purduerov/X19-Power-Slab-Board/X19-Power-Slab-Board.csv

Reference | Qty | Value | DNP | Exclude from BOM | Exclude from Board | Footprint | Datasheet | Manufacturer_Name | Manufacturer_Part_Number
3.3V1 | 1 | 3.3V |  |  |  | TestPoint:TestPoint_Pad_D2.5mm
5.1V1 | 1 | 5.1V |  |  |  | TestPoint:TestPoint_Pad_D2.5mm
12V1 | 1 | 12V |  |  |  | TestPoint:TestPoint_Pad_D4.0mm
48V1 | 1 | 48V |  |  |  | TestPoint:TestPoint_Pad_D4.0mm
B2,B3,B4,B5 | 4 | E48SC12030NRFH |  |  |  | rov_power:E48SC12030NRFH | https://filecenter.deltaww.com/products/download/01/0102/datasheet/DS_E48SC12030.pdf | Delta Electronics | E48SC12030NRFH
C1,C2 | 2 | 470u |  |  |  | Capacitor_THT:CP_Radial_D13.0mm_P5.00mm
C3 | 1 | 10u |  |  |  | Capacitor_SMD:C_1206_3216Metric_Pad1.33x1.80mm_HandSolder
C4,C5,C6,C19,C42,C43 | 6 | 0.1uF |  |  |  | Capacitor_SMD:C_0603_1608Metric_Pad1.08x0.95mm_HandSolder
C7,C9,C10,C12 | 4 | 100n |  |  |  | Capacitor_SMD:C_0603_1608Metric_Pad1.08x0.95mm_HandSolder
C8,C14 | 2 | 27pF |  |  |  | Capacitor_SMD:C_0603_1608Metric_Pad1.08x0.95mm_HandSolder
C11 | 1 | 4.7u |  |  |  | Capacitor_SMD:C_1206_3216Metric_Pad1.33x1.80mm_HandSolder
C13 | 1 | 2.2u |  |  |  | Capacitor_SMD:C_1206_3216Metric_Pad1.33x1.80mm_HandSolder
C15 | 1 | 0.1u |  |  |  | Capacitor_SMD:C_0603_1608Metric_Pad1.08x0.95mm_HandSolder
C16,C22,C30,C34,C39 | 5 | 100uF |  |  |  | Capacitor_THT:CP_Radial_D10.0mm_P5.00mm
C17,C18,C21 | 3 | 1uF |  |  |  | Capacitor_SMD:C_0603_1608Metric_Pad1.08x0.95mm_HandSolder
C20 | 1 | 22uF |  |  |  | Capacitor_SMD:C_1206_3216Metric_Pad1.33x1.80mm_HandSolder
C23,C26,C27,C31,C32,C33,C37,C38 | 8 | 1uF |  |  |  | Capacitor_SMD:C_0805_2012Metric_Pad1.18x1.45mm_HandSolder
C24,C25,C28,C29,C35,C36,C40,C41 | 8 | 470uF |  |  |  | Capacitor_THT:CP_Radial_D10.0mm_P5.00mm
C44 | 1 | 4.7n | DNP |  |  | Capacitor_SMD:C_0603_1608Metric_Pad1.08x0.95mm_HandSolder
CR2 | 1 | ESD2CAN24DBZRQ1 |  |  |  | Package_TO_SOT_SMD:SOT-23_Handsoldering | ESD2CAN24DBZRQ1
D1 | 1 | LED |  |  |  | LED_SMD:LED_0805_2012Metric_Pad1.15x1.40mm_HandSolder
D2 | 1 | SMCJ58A |  |  |  | Diode_SMD:D_SMC | https://www.littelfuse.com/assetdocs/littelfuse_tvs_diode_smcj_datasheet.pdf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
D3,D6 | 2 | YELLOW |  |  |  | LED_SMD:LED_0805_2012Metric_Pad1.15x1.40mm_HandSolder
D5 | 1 | GREEN |  |  |  | LED_SMD:LED_0805_2012Metric_Pad1.15x1.40mm_HandSolder
GND1 | 1 | GND |  |  |  | TestPoint:TestPoint_Pad_D2.5mm
J1,J3 | 2 | Conn_01x03_Pin |  |  |  | Connector_PinHeader_2.54mm:PinHeader_1x03_P2.54mm_Vertical
J2 | 1 | 796636-6 |  |  |  | rov_connectors:CON6_P5MM_VER_TERM-BLK_TYC | https://www.te.com/commerce/DocumentDelivery/DDEController?Action=srchrtrv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
J4 | 1 | Conn_01x04_Pin |  |  |  | Connector_PinHeader_2.54mm:PinHeader_1x04_P2.54mm_Vertical
J5 | 1 | Conn_02x05_Odd_Even |  |  |  | Connector_PinHeader_2.54mm:PinHeader_2x05_P2.54mm_Vertical
J6,J7,J8,J9,J10,J11,J12,J13 | 8 | Conn_01x02 |  |  |  | Connector_PinHeader_2.54mm:PinHeader_1x02_P2.54mm_Vertical
J14 | 1 | Conn_01x05 |  |  |  | Connector_PinHeader_2.54mm:PinHeader_1x05_P2.54mm_Vertical
PG1,PG2,PG3,PG4 | 4 | TestPoint |  |  |  | TestPoint:TestPoint_Pad_D2.5mm
R1 | 1 | 300 |  |  |  | Resistor_SMD:R_0603_1608Metric_Pad0.98x0.95mm_HandSolder
R2 | 1 | 1000 |  |  |  | Resistor_SMD:R_0603_1608Metric_Pad0.98x0.95mm_HandSolder
R3,R7 | 2 | 120 |  |  |  | Resistor_SMD:R_0603_1608Metric_Pad0.98x0.95mm_HandSolder
R6,R8,R9,R10 | 4 | 4.7k |  |  |  | Resistor_SMD:R_0603_1608Metric_Pad0.98x0.95mm_HandSolder
R11 | 1 | 10k |  |  |  | Resistor_THT:R_Array_SIP4
R13 | 1 | 10K |  |  |  | Resistor_SMD:R_0603_1608Metric_Pad0.98x0.95mm_HandSolder
R14 | 1 | 15.4K |  |  |  | Resistor_SMD:R_0603_1608Metric_Pad0.98x0.95mm_HandSolder
R15 | 1 | 23.7K |  |  |  | Resistor_SMD:R_0603_1608Metric_Pad0.98x0.95mm_HandSolder
R16 | 1 | 36.5K |  |  |  | Resistor_SMD:R_0603_1608Metric_Pad0.98x0.95mm_HandSolder
R17,R18,R19,R20 | 4 | 54.9K |  |  |  | Resistor_SMD:R_0603_1608Metric_Pad0.98x0.95mm_HandSolder
R21,R22 | 2 | 4.7K |  |  |  | Resistor_SMD:R_0603_1608Metric_Pad0.98x0.95mm_HandSolder
R23,R24 | 2 | SR: 1m |  |  |  | Resistor_SMD:R_2512_6332Metric_Pad1.40x3.35mm_HandSolder
R25,R26 | 2 | 60 | DNP |  |  | Resistor_SMD:R_0603_1608Metric_Pad0.98x0.95mm_HandSolder
R27 | 1 | 798K |  |  |  | Resistor_SMD:R_0603_1608Metric_Pad0.98x0.95mm_HandSolder
R28 | 1 | 10k |  |  |  | Resistor_SMD:R_0603_1608Metric_Pad0.98x0.95mm_HandSolder
SW1 | 1 | SW_Push |  |  |  | Button_Switch_THT:SW_NKK_GW12LJP
TP6,TP7 | 2 | TestPoint |  |  |  | TestPoint:TestPoint_Pad_D4.0mm
U1 | 1 | TCAN1044AEV-Q1 |  |  |  | rov_logic:D0008A-IPC_A | https://www.ti.com/lit/ds/symlink/tcan1044aev-q1.pdf?ts=1718715491235
U2 | 1 | TMP1075NDRLR |  |  |  | rov_sensors:SOT5X3-6_DRL_TEX | https://www.ti.com/lit/gpn/tmp1075
U3 | 1 | STM32C542CCT6 |  |  |  | rov_logic:LQFP48-7X7 | https://www.st.com/resource/en/datasheet/stm32c542cc.pdf
U4 | 1 | MIC5504-3.3YM5-TR |  |  |  | rov_power:SOT-23-5_MC_MCH | MIC5504-3.3YM5-TR
U5,U6 | 2 | INA237AIDGSR |  |  |  | rov_sensors:VSSOP_IDGSR_TEX | https://www.ti.com/lit/gpn/ina237
U7 | 1 | i6A4W020A033V-003-R |  |  |  | i6A4W_DIP_FULL_TDK.kicad_mod:i6A4W_DIP_FULL_TDK | https://product.tdk.com/system/files/dam/doc/product/power/switching-power/dc-dc-converter/catalog/i6a4w_e.pdf
Y1 | 1 | ABM8G-16.000MHZ-18-D2Y-T |  |  |  | footprints:CRYSTAL_ABM8G_ABR | ABM8G-16.000MHZ-18-D2Y-T
