purduerov/X19-Power-Slab-Board/DigikeyParts/E48SC12030NRFH/E48SC12030NRFH/3D/E48SC12030NRFH.stp

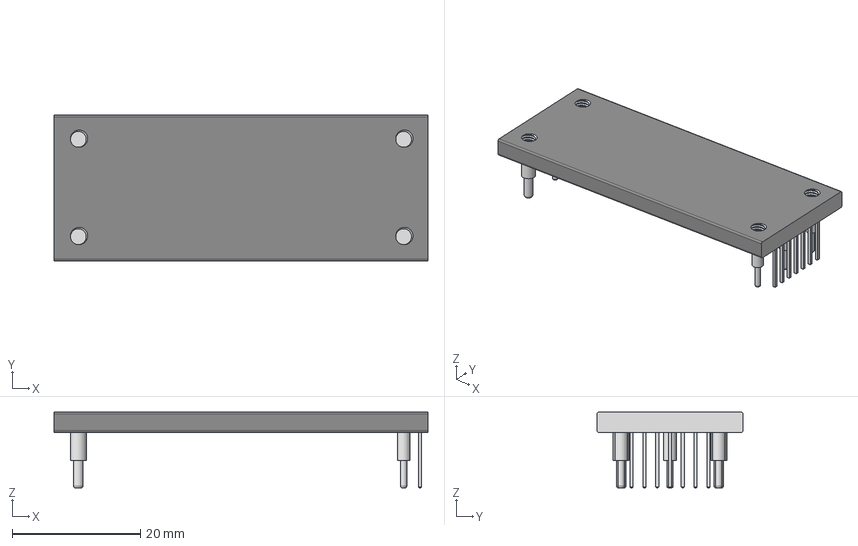
[picture p1: CAD file, 2026-09-21]
DigikeyParts/E48SC12030NRFH/E48SC12030NRFH/3D/E48SC12030NRFH.stp
58.4 x 22.8 x 11.9 mm
