purduerov/X19-Power-Slab-Board/DigikeyParts/LIB_IRS-5_10-Q12P-C/IRS-5_10-Q12P-C/3D/IRS-5_10-Q12P-C.stp

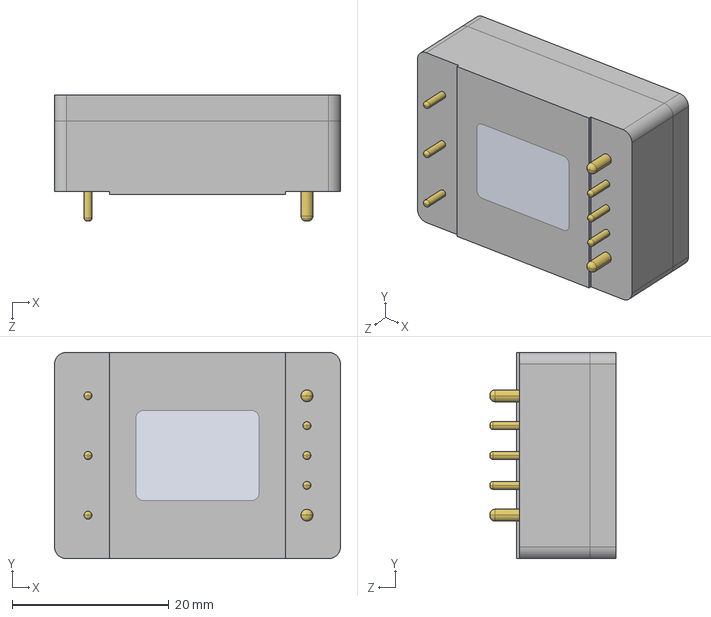
[picture p2: CAD file, 2026-10-07]
DigikeyParts/LIB_IRS-5_10-Q12P-C/IRS-5_10-Q12P-C/3D/IRS-5_10-Q12P-C.stp
36.5 x 26.3 x 16.1 mm
