purduerov/X19-Power-Slab-Board/DigikeyParts/XT60_YELLOW/XT60_YELLOW.step

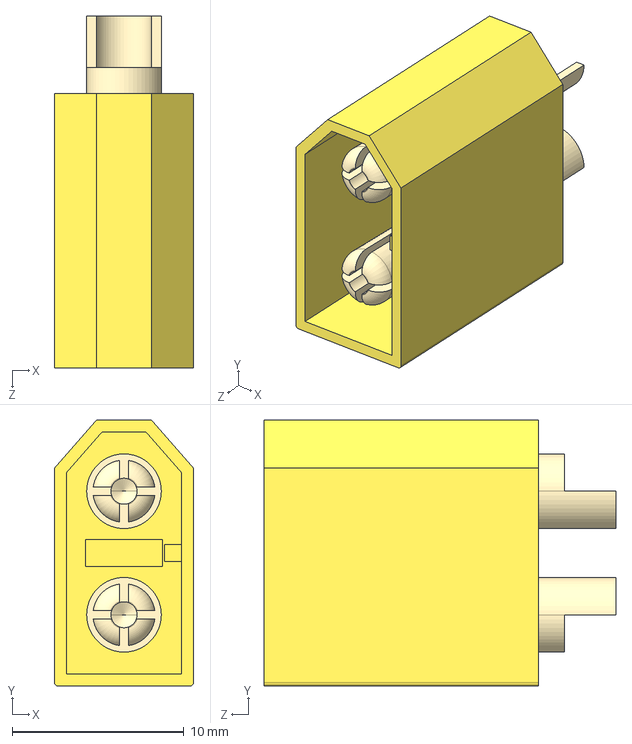
[picture p3: CAD file, 2026-10-28]
DigikeyParts/XT60_YELLOW/XT60_YELLOW.step
8.10 x 15.5 x 20.5 mm
