purduerov/X19-Power-Slab-Board/(list of files, cad)

Other CAD files:
DigikeyParts/E48SC12030NRFH/E48SC12030NRFH/Allegro/e48sc12030nrfh.psm
DigikeyParts/E48SC12030NRFH/E48SC12030NRFH/DEHDL/e48sc12030nrfh/chips/chips.prt
DigikeyParts/LIB_IRS-5_10-Q12P-C/IRS-5_10-Q12P-C/DEHDL/irs_5_10_q12p_c/chips/chips.prt
