purduerov/X19-Power-Slab-Board/(list of files, drawings)

Other design files:
DigikeyParts/E48SC12030NRFH/E48SC12030NRFH/Altium/E48SC12030NRFH.PcbLib
DigikeyParts/E48SC12030NRFH/E48SC12030NRFH/Altium/E48SC12030NRFH.SchLib
