purduerov/X19-Power-Slab-Board/X19-Power-Slab-Board.kicad_pcb

## KiCad design X19-Power-Slab-Board.kicad_pcb (2026-11-14)

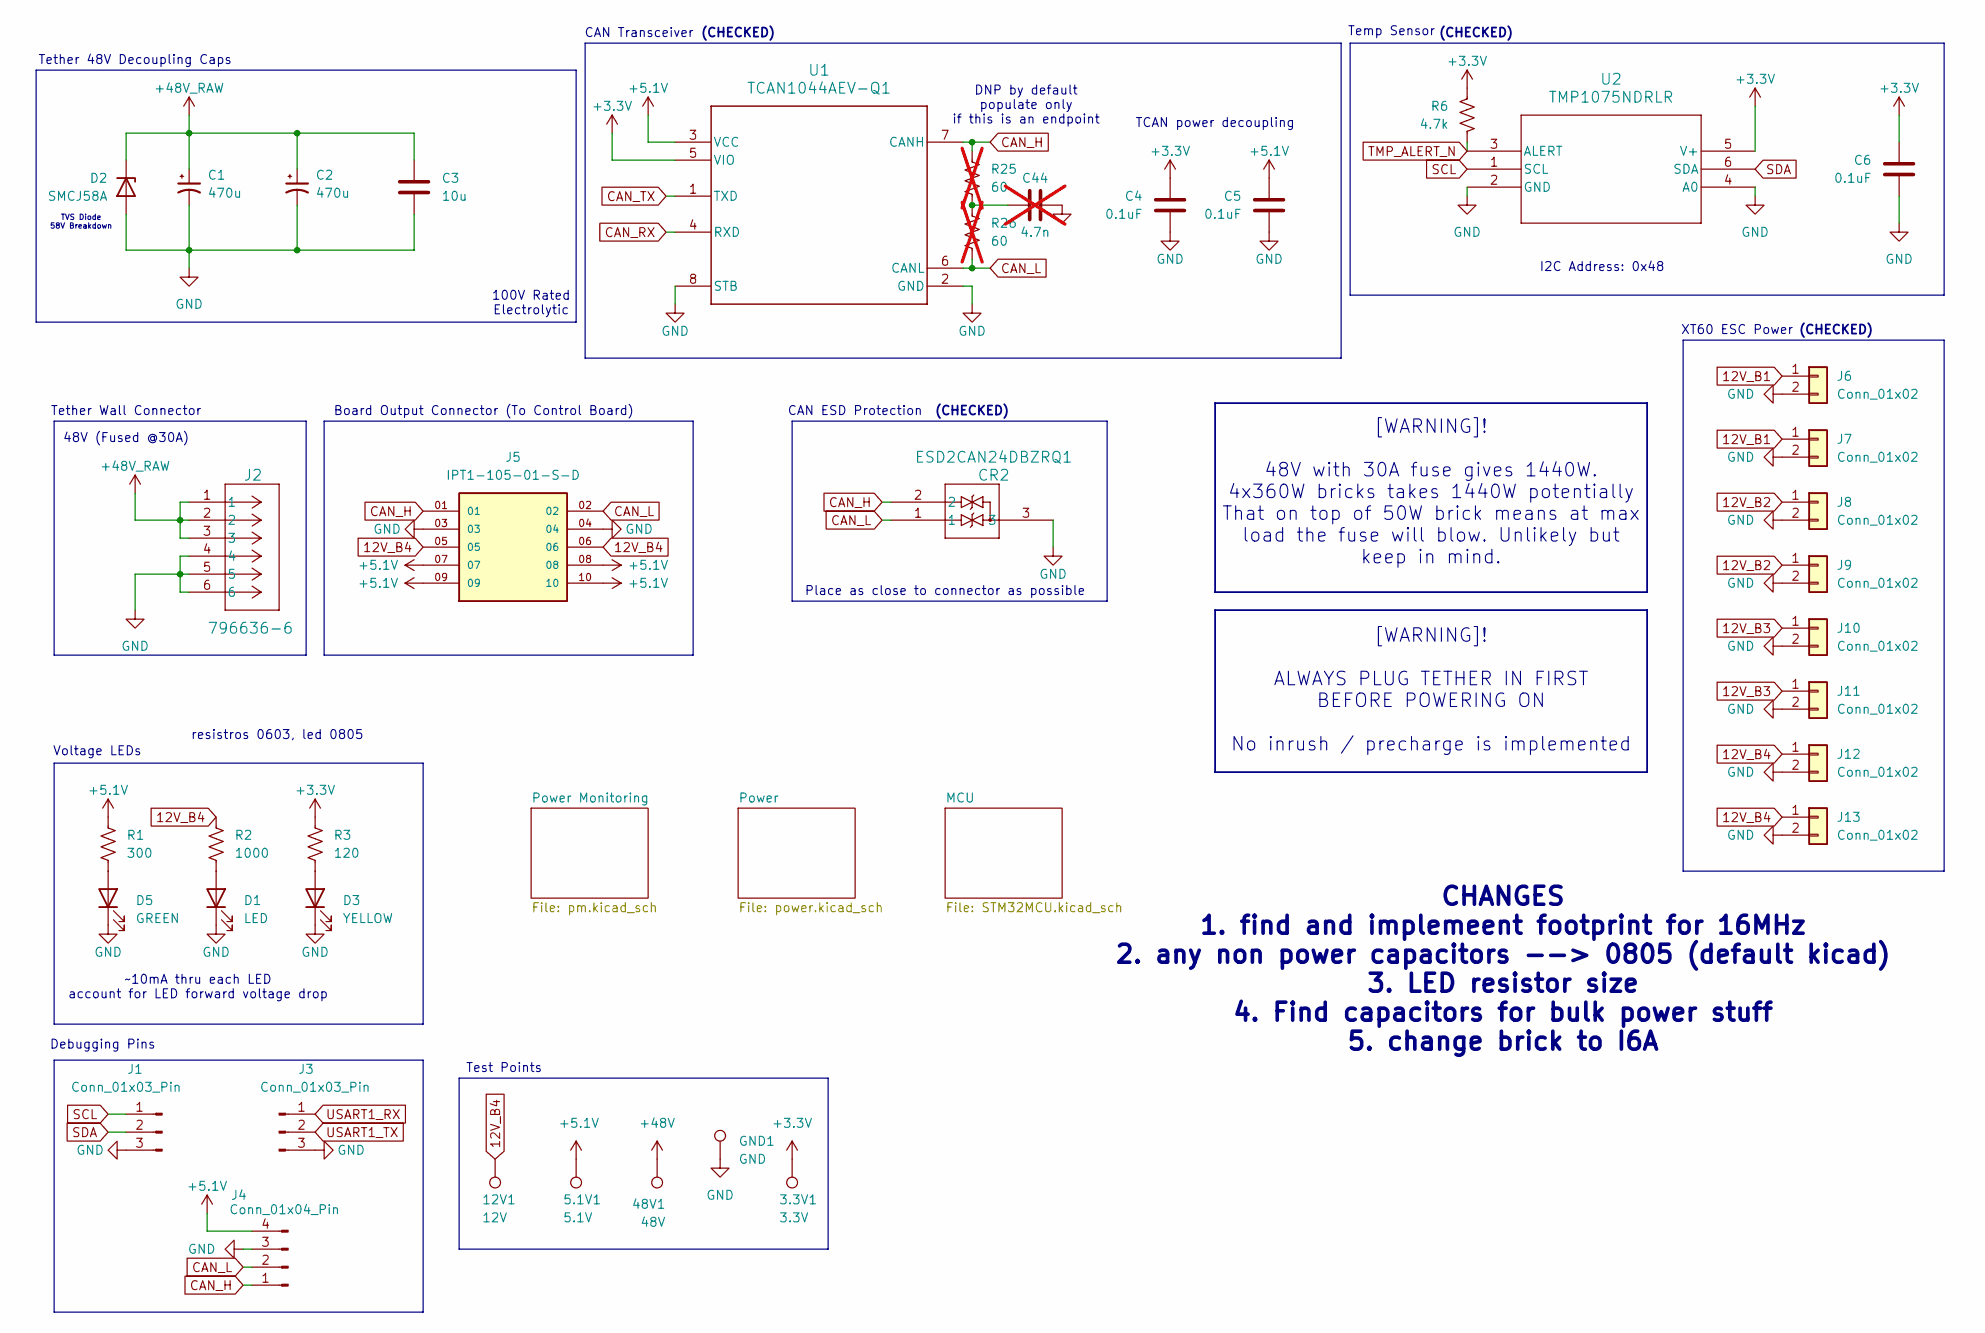
[picture p4: schematic X19-Power-Slab-Board.kicad_sch, Purdue ROV Subsystem Board]

Parts:
3.3V1: 3.3V; TestPoint_Pad_D2.5mm
5.1V1: 5.1V; TestPoint_Pad_D2.5mm
12V1: 12V; TestPoint_Pad_D4.0mm
48V1: 48V; TestPoint_Pad_D4.0mm
C1, C2: 470u; CP_Radial_D13.0mm_P5.00mm
C3: 10u; C_1206_3216Metric_Pad1.33x1.80mm_HandSolder
C4, C5, C6: 0.1uF; C_0603_1608Metric_Pad1.08x0.95mm_HandSolder
C44: 4.7n; C_0603_1608Metric_Pad1.08x0.95mm_HandSolder; not fitted
CR2: ESD2CAN24DBZRQ1; SOT-23_Handsoldering
D1: LED; LED_0805_2012Metric_Pad1.15x1.40mm_HandSolder
D2: SMCJ58A; D_SMC
D3: YELLOW; LED_0805_2012Metric_Pad1.15x1.40mm_HandSolder
D5: GREEN; LED_0805_2012Metric_Pad1.15x1.40mm_HandSolder
GND1: GND; TestPoint_Pad_D2.5mm
J1, J3: Conn_01x03_Pin; PinHeader_1x03_P2.54mm_Vertical
J2: 796636-6; CON6_P5MM_VER_TERM-BLK_TYC
J4: Conn_01x04_Pin; PinHeader_1x04_P2.54mm_Vertical
J5: IPT1-105-01-S-D; SAMTEC_IPT1-105-01-S-D; PARTREV R
J6, J7, J8, J9, J10, J11, J12, J13: Conn_01x02; AMASS_XT60PB-M
R1: 300; R_0603_1608Metric_Pad0.98x0.95mm_HandSolder
R2: 1000; R_0603_1608Metric_Pad0.98x0.95mm_HandSolder
R3: 120; R_0603_1608Metric_Pad0.98x0.95mm_HandSolder
R6: 4.7k; R_0603_1608Metric_Pad0.98x0.95mm_HandSolder
R25, R26: 60; R_0603_1608Metric_Pad0.98x0.95mm_HandSolder; not fitted
U1: TCAN1044AEV-Q1; D0008A-IPC_A
U2: TMP1075NDRLR; SOT5X3-6_DRL_TEX

Connections:
12V_B1: J6.1, J7.1; also elsewhere on the board
12V_B2: J8.1, J9.1; also elsewhere on the board
12V_B3: J10.1, J11.1; also elsewhere on the board
12V_B4: 12V1.1 (1_1), J5.05, J5.06, J12.1, J13.1, R2.2; also elsewhere on the board
+3.3V: 3.3V1.1 (1_1), C4.1, C6.1, R3.2, R6.1, U1.5 (VIO), U2.5 (V+); also elsewhere on the board
+5.1V: 5.1V1.1 (1_1), C5.1, J4.4, J5.07, J5.08, J5.09, J5.10, R1.2, U1.3 (VCC); also elsewhere on the board
+48V: 48V1.1 (1_1); also elsewhere on the board
+48V_RAW: C1.1, C2.1, C3.1, D2.1 (K), J2.1, J2.2, J2.3; also elsewhere on the board
CAN_H: CR2.2, J4.1, J5.01, R25.1, U1.7 (CANH)
CAN_L: CR2.1, J4.2, J5.02, R26.2, U1.6 (CANL)
CAN_RX: U1.4 (RXD); also elsewhere on the board
CAN_TX: U1.1 (TXD); also elsewhere on the board
GND: C1.2, C2.2, C3.2, C4.2, C5.2, C6.2, C44.2, CR2.3, D1.1 (K), D2.2 (A), D3.1 (K), D5.1 (K), GND1.1 (1_1), J1.3, J2.4, J2.5, J2.6, J3.3, J4.3, J5.03, J5.04, J6.2, J7.2, J8.2, J9.2, J10.2, J11.2, J12.2, J13.2, U1.2 (GND), U1.8 (STB), U2.2 (GND), U2.4 (A0); also elsewhere on the board
unnamed: C44.1, R25.2, R26.1
unnamed: D1.2 (A), R2.1
unnamed: D3.2 (A), R3.1
unnamed: D5.2 (A), R1.1
SCL: J1.1, U2.1 (SCL); also elsewhere on the board
SDA: J1.2, U2.6 (SDA); also elsewhere on the board
TMP_ALERT_N: R6.2, U2.3 (ALERT); also elsewhere on the board
USART1_RX: J3.1; also elsewhere on the board
USART1_TX: J3.2; also elsewhere on the board

Notes on the sheet:
TCAN power decoupling
(CHECKED)
resistros 0603, led 0805
100V Rated Electrolytic
XT60 ESC Power
CAN Transceiver
I2C Address: 0x48
DNP by default populate only if this is an endpoint
[WARNING]! 48V with 30A fuse gives 1440W. 4x360W bricks takes 1440W potentially That on top of 50W brick means at max load the fuse will blow. Unlikely but keep in mind.
Place as close to connector as possible
Temp Sensor
Board Output Connector (To Control Board)
TVS Diode 58V Breakdown
~10mA thru each LED account for LED forward voltage drop
CAN ESD Protection
Tether 48V Decoupling Caps
Voltage LEDs
CHANGES 1. find and implemeent footprint for 16MHz 2. any non power capacitors --> 0805 (default kicad) 3. LED resistor size 4. Find capacitors for bulk power stuff 5. change brick to I6A
[WARNING]! ALWAYS PLUG TETHER IN FIRST BEFORE POWERING ON No inrush / precharge is implemented
Test Points
Debugging Pins
Tether Wall Connector
48V (Fused @30A)

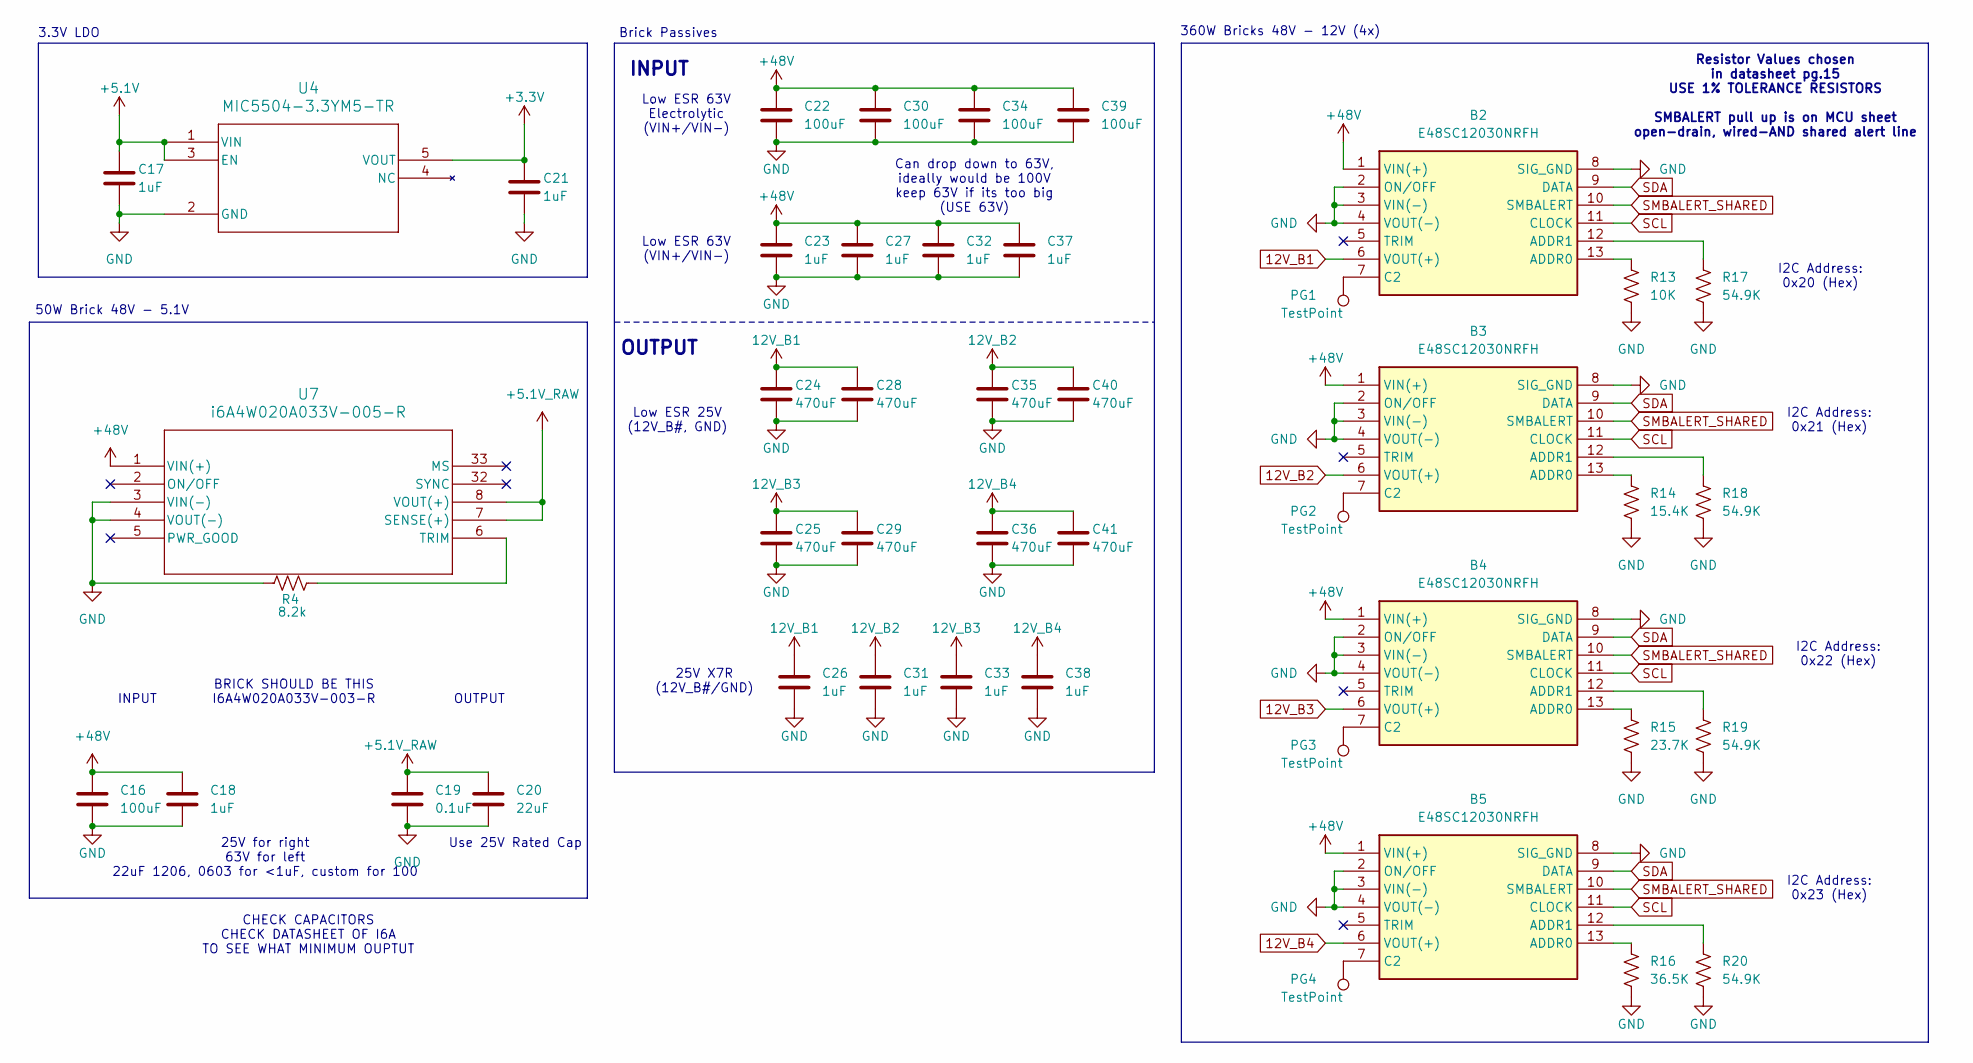
[picture p5: schematic power.kicad_sch]

Parts:
B2, B3, B4, B5: E48SC12030NRFH; Manufacturer_Part_Number E48SC12030NRFH
C16, C22, C30, C34, C39: 100uF; CP_Radial_D10.0mm_P5.00mm
C17, C18, C21: 1uF; C_0603_1608Metric_Pad1.08x0.95mm_HandSolder
C19: 0.1uF; C_0603_1608Metric_Pad1.08x0.95mm_HandSolder
C20: 22uF; C_1206_3216Metric_Pad1.33x1.80mm_HandSolder
C23, C26, C27, C31, C32, C33, C37, C38: 1uF; C_0805_2012Metric_Pad1.18x1.45mm_HandSolder
C24, C25, C28, C29, C35, C36, C40, C41: 470uF; CP_Radial_D10.0mm_P5.00mm
PG1, PG2, PG3, PG4: TestPoint; TestPoint_Pad_D2.5mm
R4: 8.2k; R_0603_1608Metric_Pad0.98x0.95mm_HandSolder
R13: 10K; R_0603_1608Metric_Pad0.98x0.95mm_HandSolder
R14: 15.4K; R_0603_1608Metric_Pad0.98x0.95mm_HandSolder
R15: 23.7K; R_0603_1608Metric_Pad0.98x0.95mm_HandSolder
R16: 36.5K; R_0603_1608Metric_Pad0.98x0.95mm_HandSolder
R17, R18, R19, R20: 54.9K; R_0603_1608Metric_Pad0.98x0.95mm_HandSolder
U4: MIC5504-3.3YM5-TR; SOT-23-5_MC_MCH
U7: i6A4W020A033V-005-R; i6A4W_DIP_FULL_TDK

Connections:
12V_B1: B2.6 (VOUT(+)), C24.1, C26.1, C28.1; also elsewhere on the board
12V_B2: B3.6 (VOUT(+)), C31.1, C35.1, C40.1; also elsewhere on the board
12V_B3: B4.6 (VOUT(+)), C25.1, C29.1, C33.1; also elsewhere on the board
12V_B4: B5.6 (VOUT(+)), C36.1, C38.1, C41.1; also elsewhere on the board
+3.3V: C21.1, U4.5 (VOUT); also elsewhere on the board
+5.1V: C17.1, U4.1 (VIN), U4.3 (EN); also elsewhere on the board
+5.1V_RAW: C19.1, C20.1, U7.7 (SENSE(+)), U7.8 (VOUT(+)); also elsewhere on the board
+48V: B2.1 (VIN(+)), B3.1 (VIN(+)), B4.1 (VIN(+)), B5.1 (VIN(+)), C16.1, C18.1, C22.1, C23.1, C27.1, C30.1, C32.1, C34.1, C37.1, C39.1, U7.1 (VIN(+)); also elsewhere on the board
GND: B2.2 (ON/OFF), B2.3 (VIN(-)), B2.4 (VOUT(-)), B2.8 (SIG_GND), B3.2 (ON/OFF), B3.3 (VIN(-)), B3.4 (VOUT(-)), B3.8 (SIG_GND), B4.2 (ON/OFF), B4.3 (VIN(-)), B4.4 (VOUT(-)), B4.8 (SIG_GND), B5.2 (ON/OFF), B5.3 (VIN(-)), B5.4 (VOUT(-)), B5.8 (SIG_GND), C16.2, C17.2, C18.2, C19.2, C20.2, C21.2, C22.2, C23.2, C24.2, C25.2, C26.2, C27.2, C28.2, C29.2, C30.2, C31.2, C32.2, C33.2, C34.2, C35.2, C36.2, C37.2, C38.2, C39.2, C40.2, C41.2, R4.1, R13.2, R14.2, R15.2, R16.2, R17.2, R18.2, R19.2, R20.2, U4.2 (GND), U7.3 (VIN(-)), U7.4 (VOUT(-)); also elsewhere on the board
unnamed: B2.13 (ADDR0), R13.1
unnamed: B2.12 (ADDR1), R17.1
unnamed: B2.7 (C2), PG1.1 (1_1)
unnamed: B3.13 (ADDR0), R14.1
unnamed: B3.12 (ADDR1), R18.1
unnamed: B3.7 (C2), PG2.1 (1_1)
unnamed: B4.13 (ADDR0), R15.1
unnamed: B4.12 (ADDR1), R19.1
unnamed: B4.7 (C2), PG3.1 (1_1)
unnamed: B5.13 (ADDR0), R16.1
unnamed: B5.12 (ADDR1), R20.1
unnamed: B5.7 (C2), PG4.1 (1_1)
unnamed: R4.2, U7.6 (TRIM)
SCL: B2.11 (CLOCK), B3.11 (CLOCK), B4.11 (CLOCK), B5.11 (CLOCK); also elsewhere on the board
SDA: B2.9 (DATA), B3.9 (DATA), B4.9 (DATA), B5.9 (DATA); also elsewhere on the board
SMBALERT_SHARED: B2.10 (SMBALERT), B3.10 (SMBALERT), B4.10 (SMBALERT), B5.10 (SMBALERT); also elsewhere on the board

Notes on the sheet:
3.3V LDO
CHECK CAPACITORS CHECK DATASHEET OF I6A TO SEE WHAT MINIMUM OUPTUT
360W Bricks 48V - 12V (4x)
Brick Passives
Low ESR 63V (VIN+/VIN-)
50W Brick 48V - 5.1V
Use 25V Rated Cap
OUTPUT
INPUT
I2C Address: 0x21 (Hex)
Low ESR 63V Electrolytic (VIN+/VIN-)
I2C Address: 0x20 (Hex)
Low ESR 25V (12V_B#, GND)
25V for right 63V for left 22uF 1206, 0603 for <1uF, custom for 100
BRICK SHOULD BE THIS I6A4W020A033V-003-R
Resistor Values chosen in datasheet pg.15 USE 1% TOLERANCE RESISTORS SMBALERT pull up is on MCU sheet open-drain, wired-AND shared alert line
25V X7R (12V_B#/GND)
I2C Address: 0x22 (Hex)
Can drop down to 63V, ideally would be 100V keep 63V if its too big (USE 63V)
I2C Address: 0x23 (Hex)

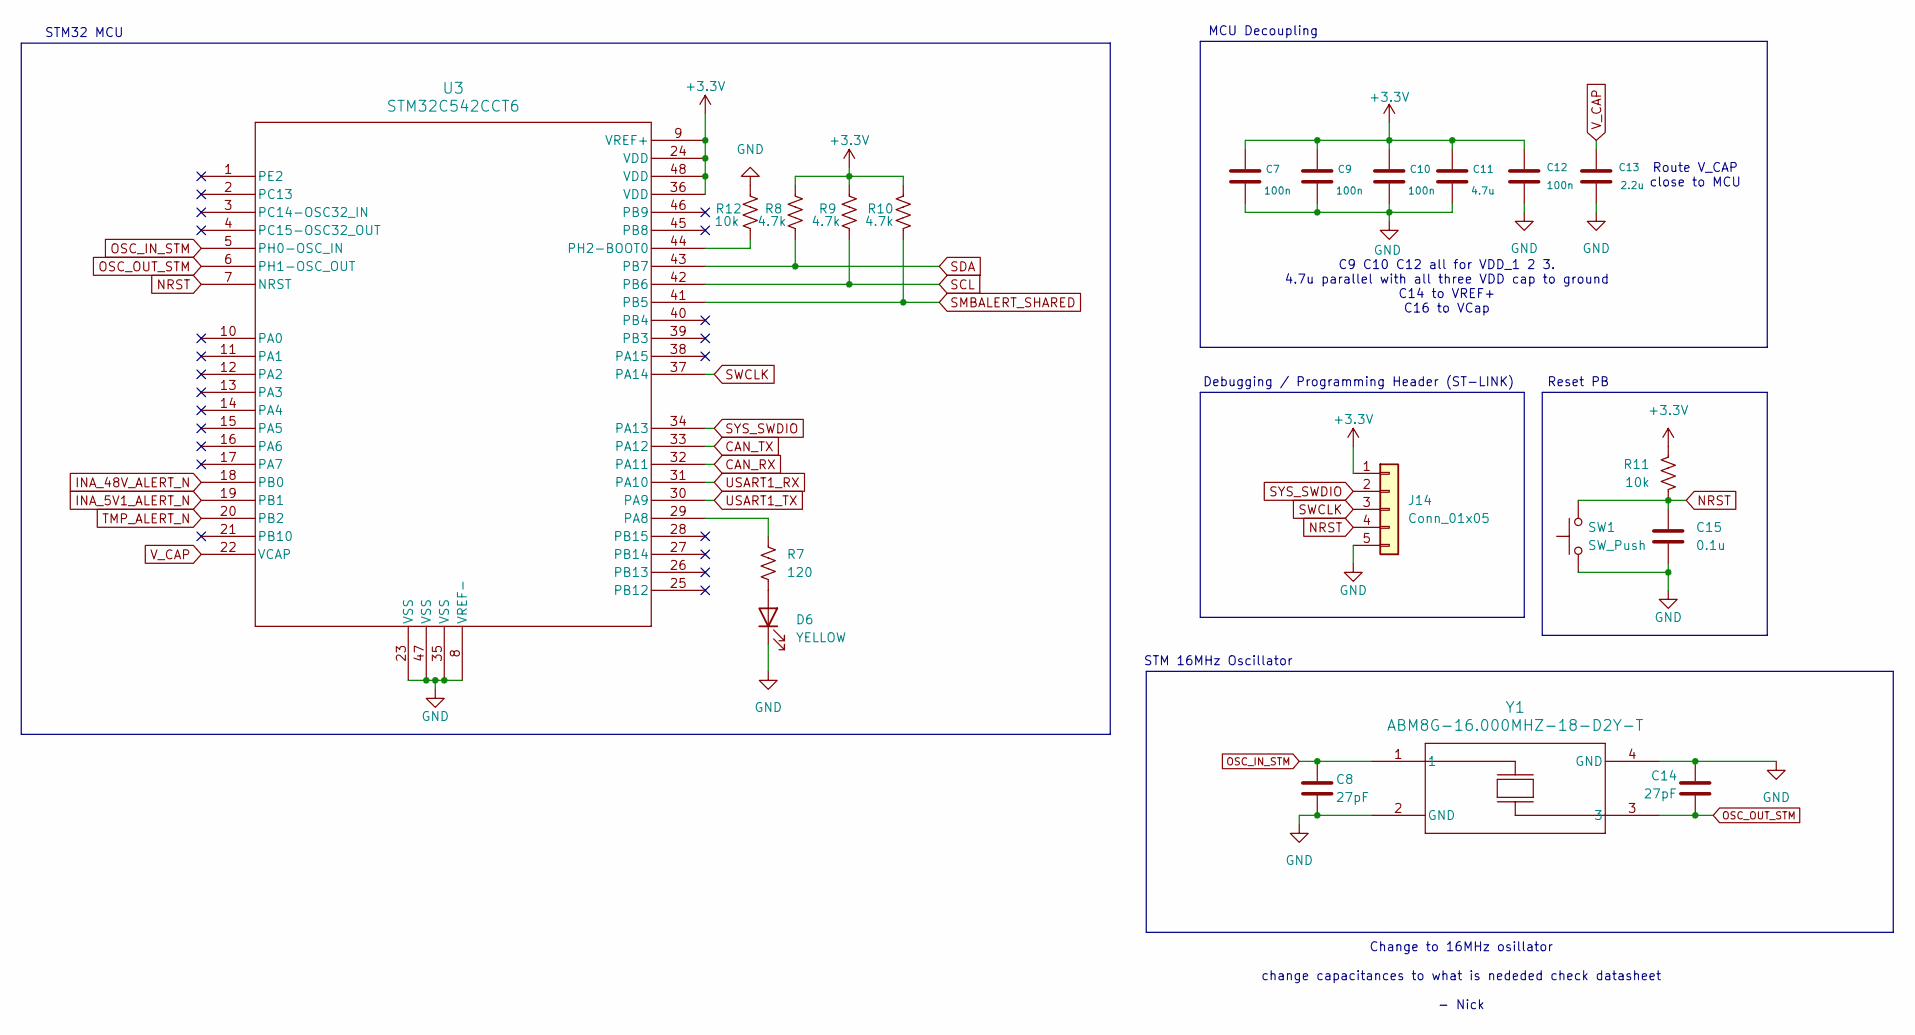
[picture p6: schematic STM32MCU.kicad_sch]

Parts:
C7, C9, C10, C12: 100n; C_0603_1608Metric_Pad1.08x0.95mm_HandSolder
C8, C14: 27pF; C_0603_1608Metric_Pad1.08x0.95mm_HandSolder
C11: 4.7u; C_0603_1608Metric_Pad1.08x0.95mm_HandSolder
C13: 2.2u; C_0603_1608Metric_Pad1.08x0.95mm_HandSolder
C15: 0.1u; C_0603_1608Metric_Pad1.08x0.95mm_HandSolder
D6: YELLOW; LED_0805_2012Metric_Pad1.15x1.40mm_HandSolder
J14: Conn_01x05; PinHeader_1x05_P2.54mm_Vertical
R7: 120; R_0603_1608Metric_Pad0.98x0.95mm_HandSolder
R8, R9, R10: 4.7k; R_0603_1608Metric_Pad0.98x0.95mm_HandSolder
R11, R12: 10k; R_0603_1608Metric_Pad0.98x0.95mm_HandSolder
SW1: SW_Push; SW_SPST_B3U-1000P
U3: STM32C542CCT6; LQFP48-7X7
Y1: ABM8G-16.000MHZ-18-D2Y-T; Crystal_SMD_3225-4Pin_3.2x2.5mm

Connections:
+3.3V: C7.1, C9.1, C10.1, C11.1, C12.1, J14.1, R8.2, R9.2, R10.1, R11.1, U3.9 (VREF+), U3.24 (VDD), U3.36 (VDD), U3.48 (VDD); also elsewhere on the board
CAN_RX: U3.32 (PA11); also elsewhere on the board
CAN_TX: U3.33 (PA12); also elsewhere on the board
GND: C7.2, C8.1, C9.2, C10.2, C11.2, C12.2, C13.2, C14.1, C15.2, D6.1 (K), J14.5, R12.2, SW1.1, U3.8 (VREF-), U3.23 (VSS), U3.35 (VSS), U3.47 (VSS), Y1.2 (GND), Y1.4 (GND); also elsewhere on the board
INA_5V1_ALERT_N: U3.19 (PB1); also elsewhere on the board
INA_48V_ALERT_N: U3.18 (PB0); also elsewhere on the board
NRST: C15.1, J14.4, R11.2, SW1.2, U3.7 (NRST)
unnamed: D6.2 (A), R7.2
unnamed: R7.1, U3.29 (PA8)
unnamed: R12.1, U3.44 (PH2-BOOT0)
OSC_IN_STM: C8.2, U3.5 (PH0-OSC_IN), Y1.1
OSC_OUT_STM: C14.2, U3.6 (PH1-OSC_OUT), Y1.3
SCL: R9.1, U3.42 (PB6); also elsewhere on the board
SDA: R8.1, U3.43 (PB7); also elsewhere on the board
SMBALERT_SHARED: R10.2, U3.41 (PB5); also elsewhere on the board
SWCLK: J14.3, U3.37 (PA14)
SYS_SWDIO: J14.2, U3.34 (PA13)
TMP_ALERT_N: U3.20 (PB2); also elsewhere on the board
USART1_RX: U3.31 (PA10); also elsewhere on the board
USART1_TX: U3.30 (PA9); also elsewhere on the board
V_CAP: C13.1, U3.22 (VCAP)

Notes on the sheet:
C9 C10 C12 all for VDD_1 2 3. 4.7u parallel with all three VDD cap to ground C14 to VREF+ C16 to VCap
Reset PB
Change to 16MHz osillator change capacitances to what is nededed check datasheet - Nick
Debugging / Programming Header (ST-LINK)
STM32 MCU
STM 16MHz Oscillator
MCU Decoupling
Route V_CAP close to MCU

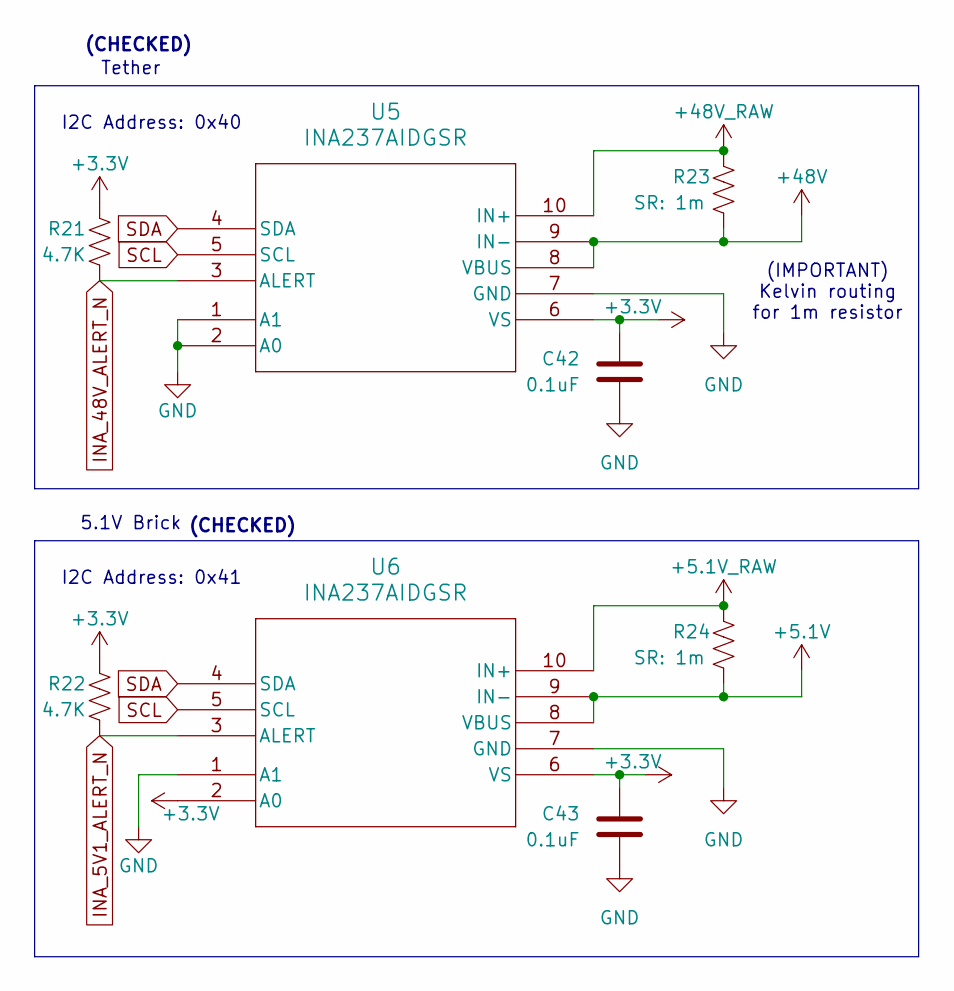
[picture p7: schematic pm.kicad_sch]

Parts:
C42, C43: 0.1uF; C_0603_1608Metric_Pad1.08x0.95mm_HandSolder
R21, R22: 4.7K; R_0603_1608Metric_Pad0.98x0.95mm_HandSolder
R23, R24: SR: 1m; R_2512_6332Metric_Pad1.40x3.35mm_HandSolder
U5, U6: INA237AIDGSR; VSSOP_IDGSR_TEX

Connections:
+3.3V: C42.1, C43.1, R21.1, R22.1, U5.6 (VS), U6.2 (A0), U6.6 (VS); also elsewhere on the board
+5.1V: R24.2, U6.8 (VBUS), U6.9 (IN-); also elsewhere on the board
+5.1V_RAW: R24.1, U6.10 (IN+); also elsewhere on the board
+48V: R23.2, U5.8 (VBUS), U5.9 (IN-); also elsewhere on the board
+48V_RAW: R23.1, U5.10 (IN+); also elsewhere on the board
GND: C42.2, C43.2, U5.1 (A1), U5.2 (A0), U5.7 (GND), U6.1 (A1), U6.7 (GND); also elsewhere on the board
INA_5V1_ALERT_N: R22.2, U6.3 (ALERT); also elsewhere on the board
INA_48V_ALERT_N: R21.2, U5.3 (ALERT); also elsewhere on the board
SCL: U5.5 (SCL), U6.5 (SCL); also elsewhere on the board
SDA: U5.4 (SDA), U6.4 (SDA); also elsewhere on the board

Notes on the sheet:
Tether
(IMPORTANT) Kelvin routing for 1m resistor
(CHECKED)
5.1V Brick
I2C Address: 0x41
I2C Address: 0x40

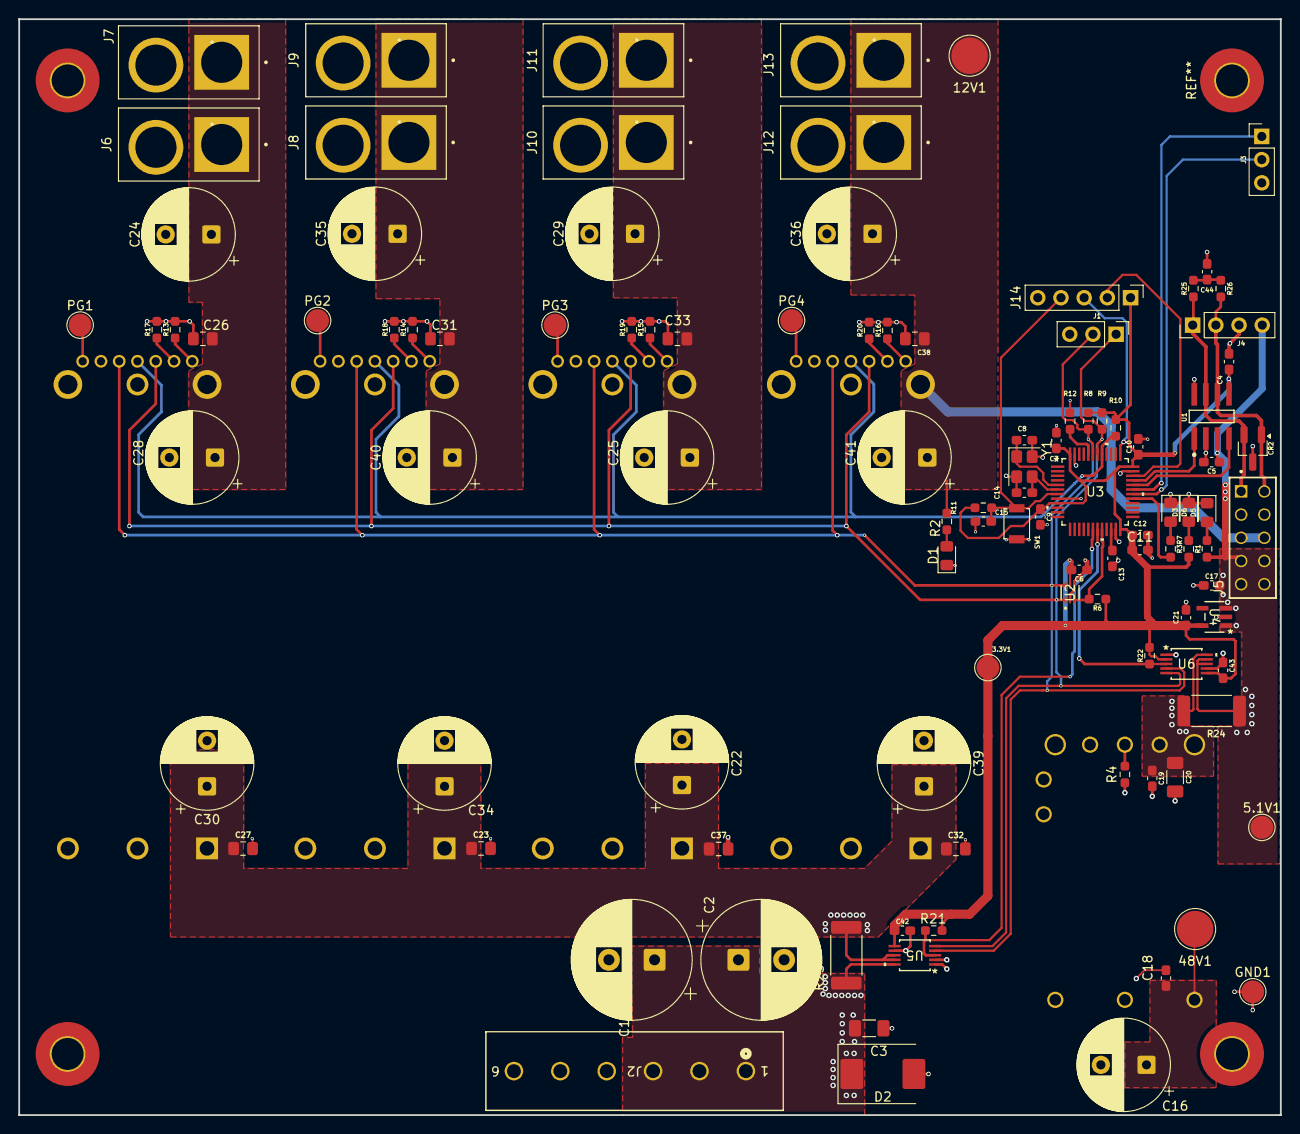
[picture p8: board X19-Power-Slab-Board.kicad_pcb from above]

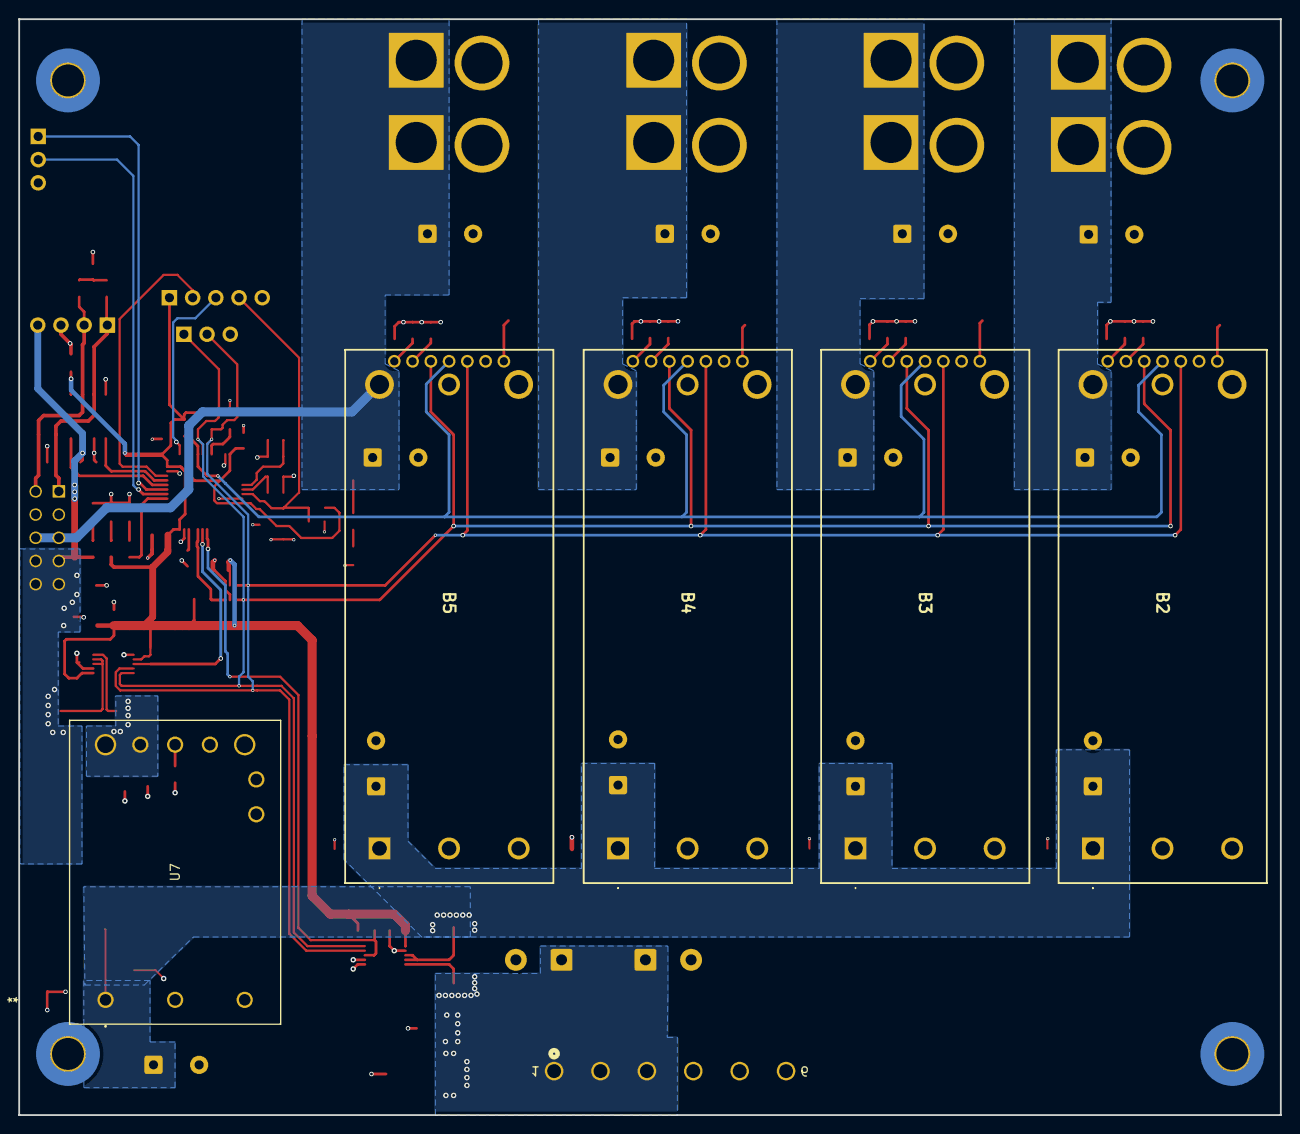
[picture p9: board X19-Power-Slab-Board.kicad_pcb from below]

Board: 4 copper layers, 138.1 x 120.0 mm, 111 parts (5 on the bottom side), 48 nets.
