purduerov/X19-Power-Slab-Board/(commit log)

2026-09-09 chore: initialize project name to X19-Power-Slab-Board and cleanup template config
    [X19-Power-Slab-Board.kicad_pcb, X19-Power-Slab-Board.kicad_sch]
2026-09-09 chore(submodule): update purdue-rov-kicad-lib to latest master
2026-09-09 chore(submodule): sync purdue-rov-kicad-lib to 3b036a0
2026-09-09 chore(submodule): sync purdue-rov-kicad-lib to b8f2bd1
2026-09-09 chore(infra): sync goated KiCad launcher, library tables, and purdue-rov-kicad-lib
2026-09-10 chore(githooks): harden submodule sync and update purdue-rov-kicad-lib
2026-09-10 chore(submodule): update purdue-rov-kicad-lib to d63fa5e
2026-09-10 chore(submodule): sync purdue-rov-kicad-lib to latest master
2026-09-19 Iteration 1 of schematic
    [STM32MCU.kicad_sch, X19-Power-Slab-Board.kicad_sch]
2026-09-19 chore(submodule): fast-forward purdue-rov-kicad-lib to latest master
2026-09-19 chore(submodule): bump purdue-rov-kicad-lib to latest master
2026-09-19 ci: set strict_drc to false to generate PDFs and artifacts for WIP boards
2026-09-20 chore(submodule): auto-update purdue-rov-kicad-lib to latest master
2026-09-21 added 48-12V bricks
    [E48SC12030NRFH.PcbLib, E48SC12030NRFH.SchLib, E48SC12030NRFH.stp, EDI2CAP.CFG, STM32+Bricks.kicad_sch, STM32+PowerBricks.kicad_sch, STM32MCU.kicad_sch, X19-Power-Slab-Board.kicad_pcb]
2026-09-21 changed one tiny label
    [STM32+Bricks.kicad_sch, STM32+PowerBricks.kicad_sch, STM32MCU.kicad_sch, X19-Power-Slab-Board.kicad_pcb, X19-Power-Slab-Board.kicad_sch, stm32.kicad_sch]
2026-09-21 Nick's changes
    [STM32MCU.kicad_sch, X19-Power-Slab-Board.kicad_sch, power.kicad_sch]
2026-09-21 Updated MCU
    [STM32MCU.kicad_sch, X19-Power-Slab-Board.kicad_sch, power.kicad_sch]
2026-09-22 fix 48V caps, and add MCU NC
    [STM32MCU.kicad_sch, X19-Power-Slab-Board.kicad_sch]
2026-09-22 Add INA237 for 12V for each brick
    [X19-Power-Slab-Board.kicad_sch, pm.kicad_sch, power.kicad_sch]
2026-09-30 Added SPI
    [STM32MCU.kicad_sch]
2026-10-03 Split SMBALERT pins and added pull-up resistors
    [STM32MCU.kicad_sch, power.kicad_sch]
2026-10-05 Added decouping caps
    [STM32MCU.kicad_sch, X19-Power-Slab-Board.kicad_sch, pm.kicad_sch, power.kicad_sch]
2026-10-06 Reverse polarity and power flow TBD, improved capacitance and labelling for nets
    [X19-Power-Slab-Board.kicad_sch, pm.kicad_sch, power.kicad_sch]
2026-10-06 Prettified, more power changes and MCU pin changes and removing redundancies
    [STM32MCU.kicad_sch, X19-Power-Slab-Board.kicad_sch, pm.kicad_sch, power.kicad_sch]
2026-10-07 Replaced improper brick with new one
    [EDI2CAP.CFG, IRS-5_10-Q12P-C.stp, STM32MCU.kicad_sch, X19-Power-Slab-Board.kicad_sch, chips.prt, pm.kicad_sch, power.kicad_sch]
2026-10-07 Bennett TODOs
    [STM32MCU.kicad_sch, X19-Power-Slab-Board.kicad_sch, power.kicad_sch]
2026-10-15 assigned some cap and res footprints
2026-10-22 deleted SPI and updated PCB
2026-10-31 placement all placed on board, but not finalized
2026-11-04 control board connector fix
2026-11-05 added another 48V polygon
2026-11-13 route board
2026-11-14 Added stitching vias and moutning hole documentation
